dmytro-buniak/key-fob-spring-release/README.md

<div align="center">

# 🔧 Spring-Release Key Fob

**A 3D-printed key fob with a spring-loaded lever that ejects the key at the push of a button. Designed from scratch in FreeCAD: parametric parts, assembly and technical drawings (ISO 2768-m).**





<br>
<p float="left">

</p>
</div>

## 🔩 **At a glance**
| | |
|---|---|
| Overall width | 49 mm |
| Overall height | 77 mm |
| Overall depth | 7 mm |
| Material | PLA |
| Design tool | FreeCAD 1.1 (Part Design and TechDraw) |

## **How it works**
* **Loaded position.** The key sits in the key case. A spring pushes the key outward, but a locking lever holds it in place.
* **Locking.** The lever is pushed against the key by its own spring, so it stays locked until you press the button.
* **Release.** Pressing the button moves the lever away from the key. The ejector spring then pushes the key out.
* **Reset.** A separate spring returns the button to its resting position.

## **Parts shown in the overview image**
* 10006_locking_lever_prt_5x55x5
* lever spring. 6.5mm diameter; 10mm free length
* 10002_release_button_prt_16.1x5x9
* 10003_key_housing_top_prt_29.8x36.7x5.1
* 10003_key_housing_top_prt_29.8x36.7x5.1 (bottom part)
* Button spring outer diameter 5.5mm; free length 16mm
* Ejector spring outer diameter 5.5mm; free length 37mm
* M3 8mm
* M3 8mm
* M3 8mm
* 10001_case_bottom_part_prt_52.5x84x7
* 10008_frame_rim_prt_52.7x84.2x7

## ⚙️ **Springs and hardware**
* **Spring**
  * Ejector spring	outer diameter 5.5mm;     free length 37mm
  * Lever spring	outer diameter 6.5mm;     free length 10mm
  * Button spring	outer diameter 5.5mm;     free length 16mm

* **Other hardware:**
  * Screws:
    * 3 M3 8mm
    * 1 M3 5mm
   
## **3D Printed and assembled**
