dmytro-buniak/key-fob-spring-release/CAD/10005_key_housing_bottom_top_asm_29.8x36.7x6.1_5.1.FCStd

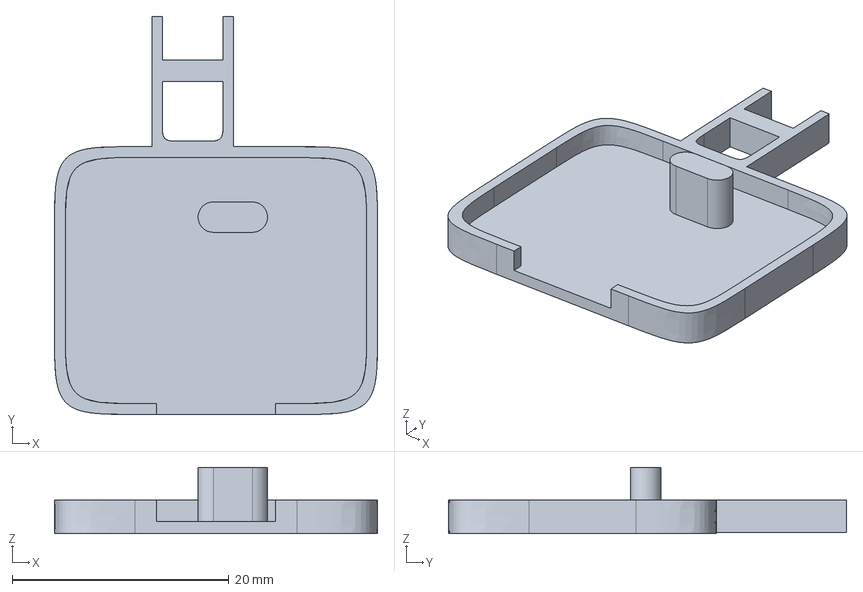
[picture p1: CAD file, 2026-10-29]
CAD/10005_key_housing_bottom_top_asm_29.8x36.7x6.1_5.1.FCStd
29.8 x 36.7 x 6.10 mm
