dmytro-buniak/key-fob-spring-release/CAD/10009_top_lid_prt_52.7x84.2x7.FCStd

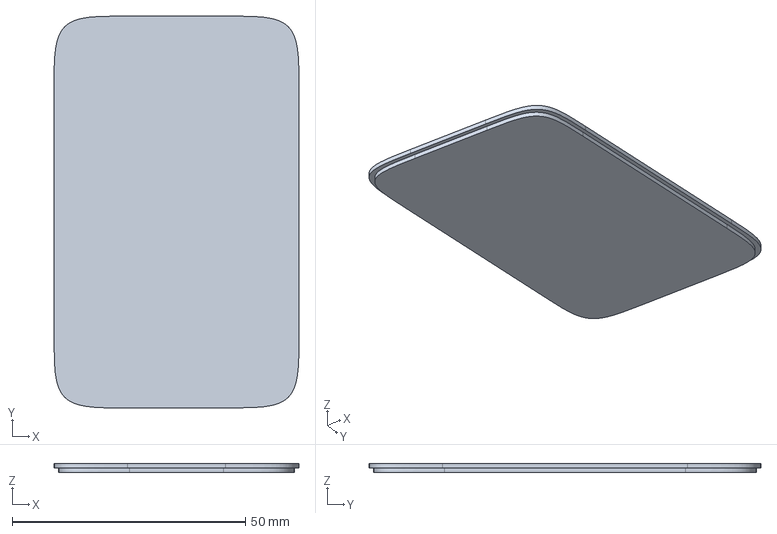
[picture p2: CAD file, 2026-11-04]
CAD/10009_top_lid_prt_52.7x84.2x7.FCStd
52.5 x 84.0 x 2.00 mm
