dmytro-buniak/key-fob-spring-release/CAD/10002_release_button_prt_16.1x5x9.FCStd

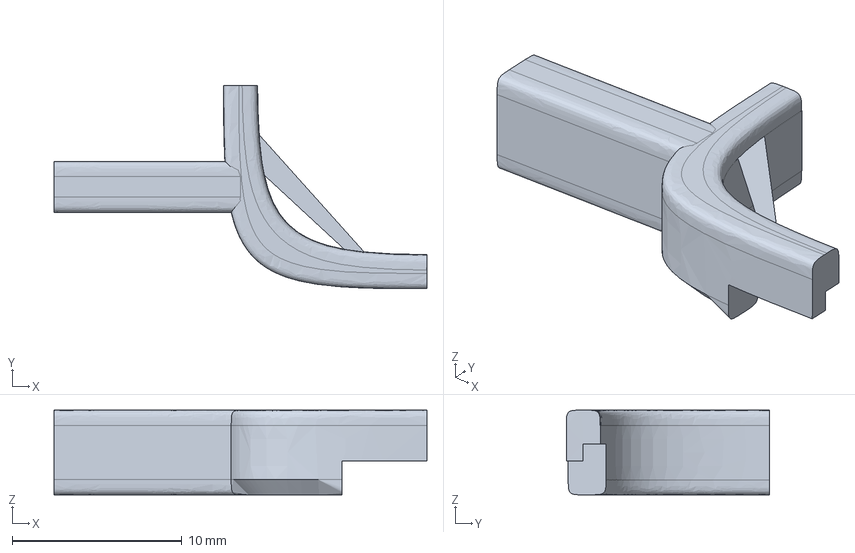
[picture p3: CAD file, 2026-10-29]
CAD/10002_release_button_prt_16.1x5x9.FCStd
22.0 x 12.0 x 5.00 mm
