dmytro-buniak/key-fob-spring-release/CAD/10006_locking_lever_prt_5x55x5.FCStd

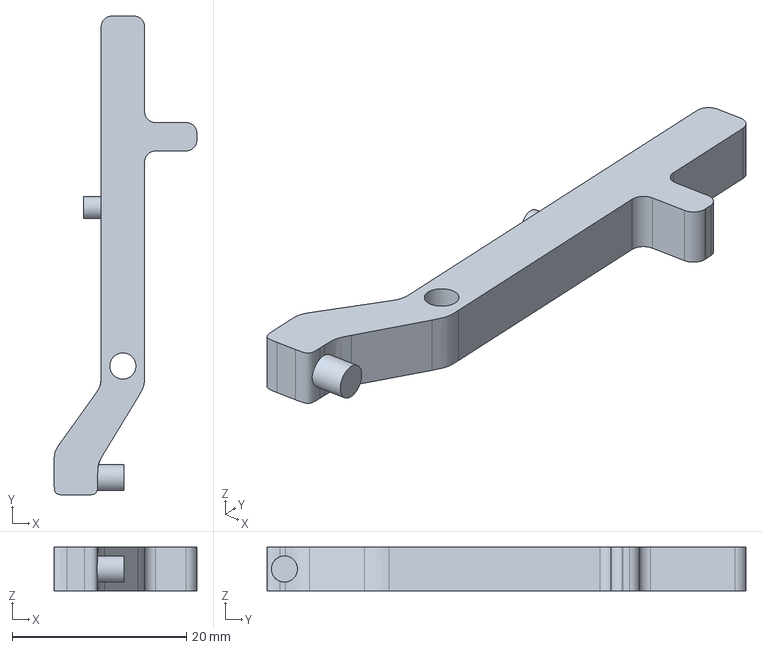
[picture p4: CAD file, 2026-10-29]
CAD/10006_locking_lever_prt_5x55x5.FCStd
16.4 x 55.0 x 5.00 mm
