dmytro-buniak/key-fob-spring-release/CAD/10001_case_bottom_part_prt_52.5x84x7.FCStd

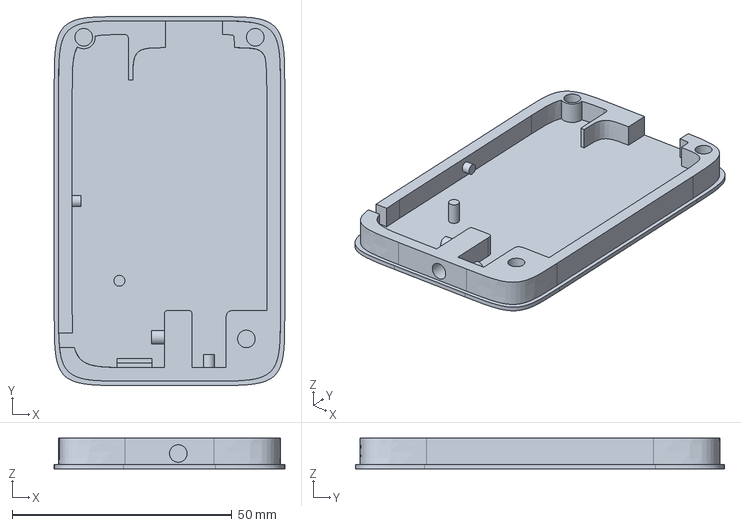
[picture p5: CAD file, 2026-10-29]
CAD/10001_case_bottom_part_prt_52.5x84x7.FCStd
52.5 x 84.0 x 7.00 mm
