dmytro-buniak/key-fob-spring-release/CAD/10008_frame_rim_prt_52.7x84.2x7.FCStd

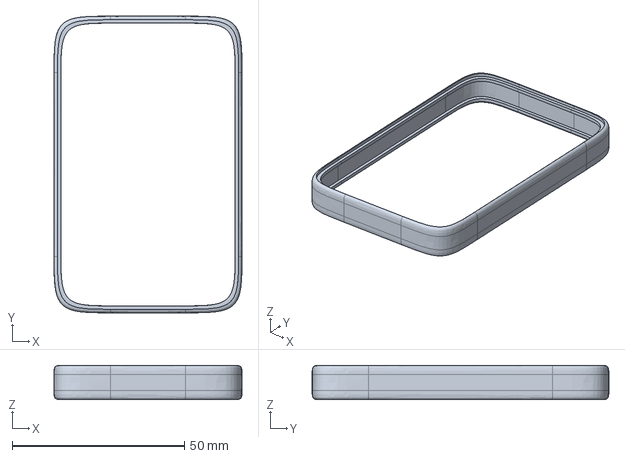
[picture p6: CAD file, 2026-10-29]
CAD/10008_frame_rim_prt_52.7x84.2x7.FCStd
54.5 x 86.0 x 9.91 mm
