dmytro-buniak/key-fob-spring-release/drawings/10016_key_fob_tech_drw_49x77x7.pdf

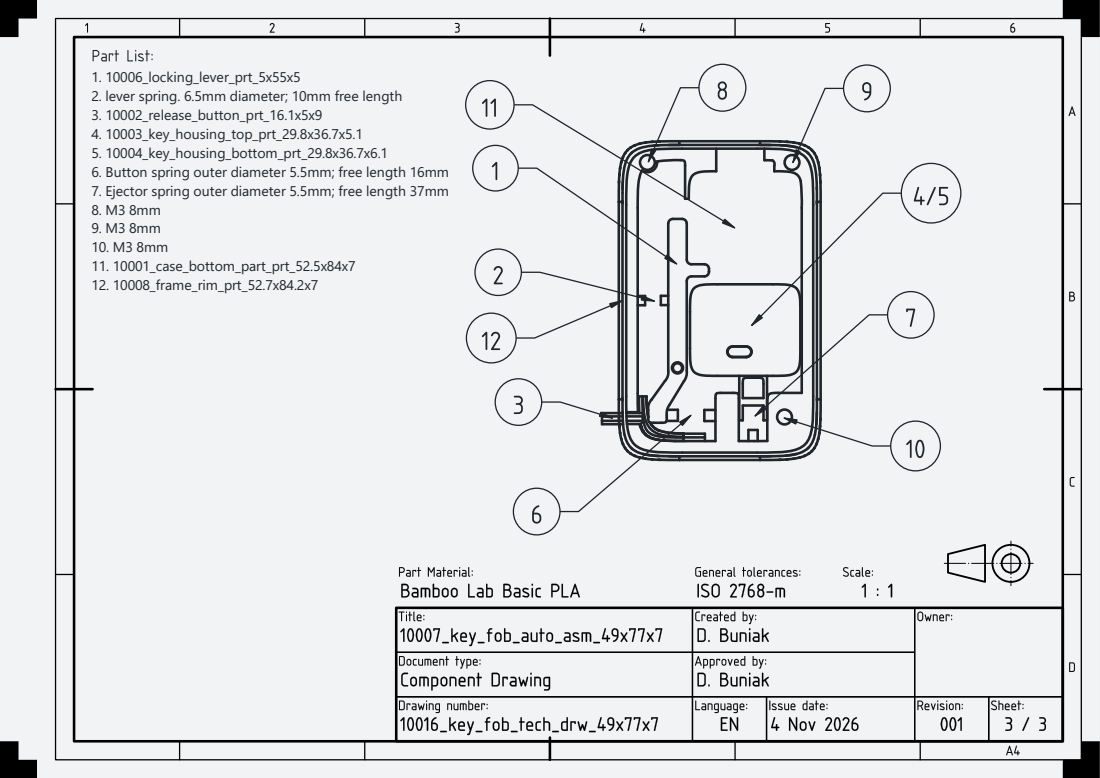
[picture p7: page 1]
1. 10006_locking_lever_prt_5x55x5 2. lever spring. 6.5mm diameter; 10mm free length 3. 10002_release_button_prt_16.1x5x9 4. 10003_key_housing_top_prt_29.8x36.7x5.1 5. 10004_key_housing_bottom_prt_29.8x36.7x6.1 6. Button spring outer diameter 5.5mm; free length 16mm 7. Ejector spring outer diameter 5.5mm; free length 37mm 8. M3 8mm 9. M3 8mm 10. M3 8mm 11. 10001_case_bottom_part_prt_52.5x84x7 12. 10008_frame_rim_prt_52.7x84.2x7
