dmytro-buniak/key-fob-spring-release/(commit log)

2026-10-29 Enhance README with key fob details and specifications
    Added detailed description of the Spring-Release Key Fob, including mechanism overview, dimensions, materials, and hardware specifications.
2026-10-30 Improve formatting of springs and hardware details
    Updated formatting for springs and hardware section in README.
2026-10-30 Format screws list in README.md
2026-11-09 Add 3D printed and assembled section to README
    Added section for 3D printed and assembled components with an image.
